NeatSleep/EEG-BCI-single-channel/hardware/breadboard.jpeg

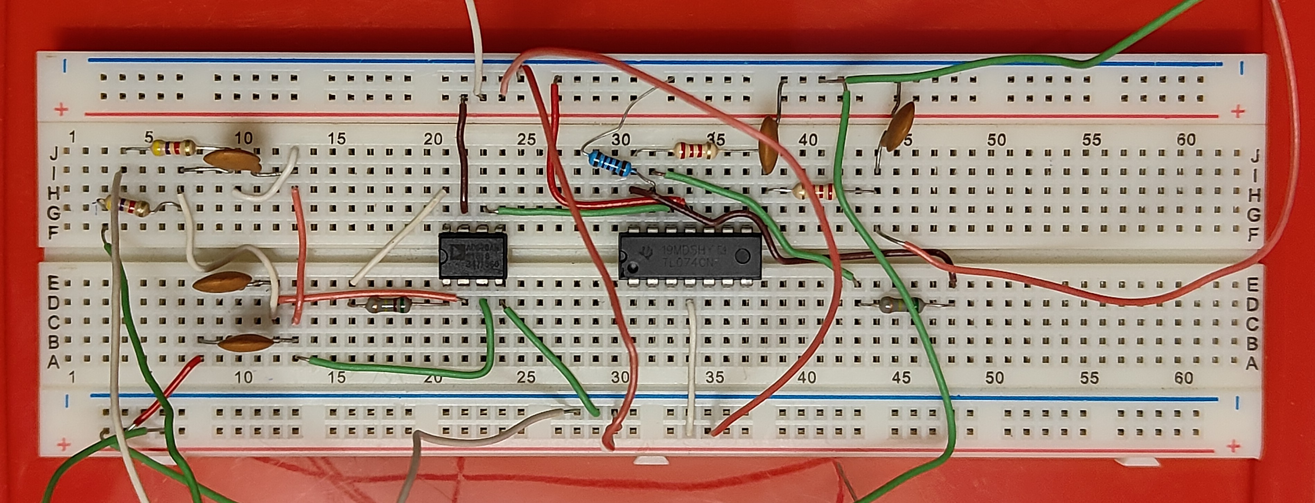
hardware/breadboard.jpeg
