NeatSleep/EEG-BCI-single-channel/hardware/schematic.png

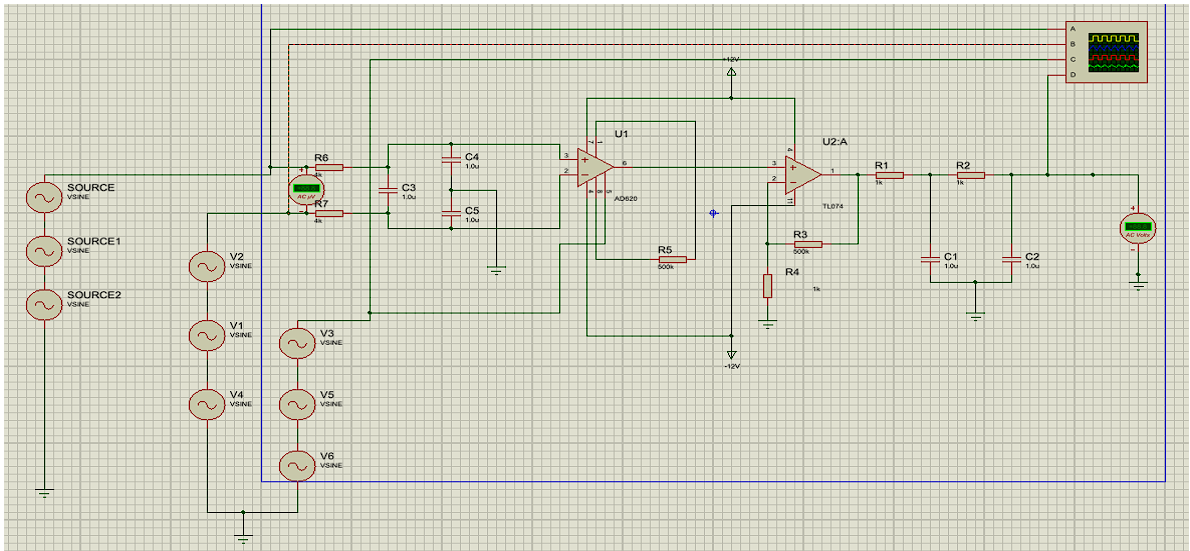
hardware/schematic.png
