NeatSleep/EEG-BCI-single-channel/(commit log)

2026-06-21 schematic added which is simulated in Proteus 9.0
2026-06-21 Document hardware components and circuit parameters
    Added a detailed list of hardware components and their purposes, along with circuit parameters for the project.
2026-06-21 Add ESP32 ADC code
2026-06-21 Add draft abstract for EEG-BCI paradigms survey
    This draft presents a hardware-grounded survey of six EEG-BCI paradigms, evaluating their feasibility based on hardware constraints. It proposes a six-axis taxonomy for BCI benchmarking.
2026-06-21 Refine analysis of BCI hardware requirements
    Clarify requirements for motor imagery and imagined speech decoding in BCI analysis.
2026-06-22 Expand README with project details and specifications
    Added detailed project description, motivation, circuit architecture, hardware specifications, and known issues related to the EEG acquisition system.
2026-06-26 Revise README for clarity and content organization
    Updated the README to improve clarity and organization of the content, including circuit architecture and references.
